magikh0e/synack-pinball/assets/social-preview.png

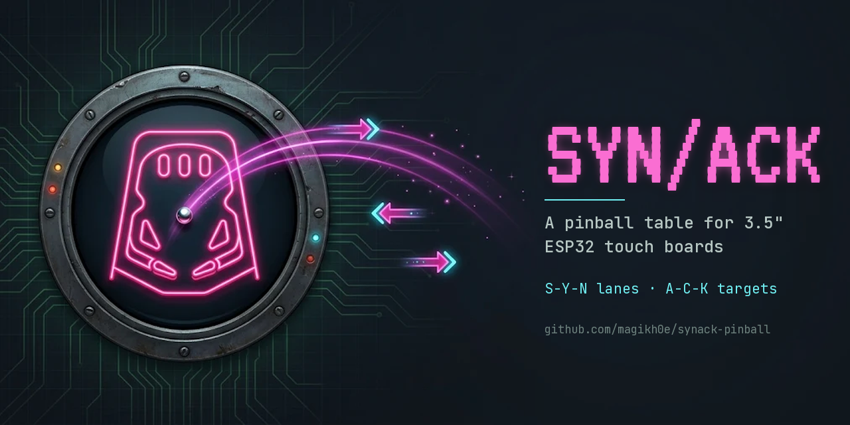
assets/social-preview.png
