magikh0e/synack-pinball/case/renders/back.png

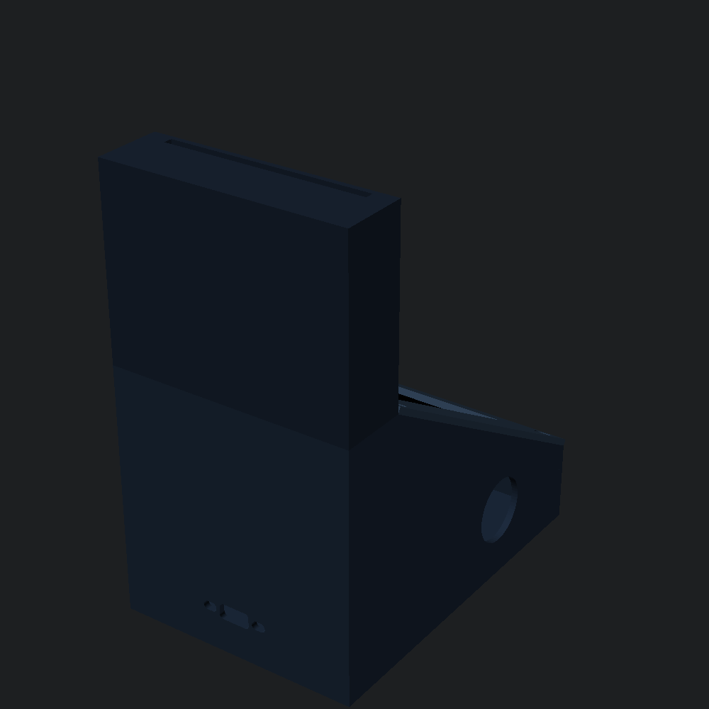
case/renders/back.png
