magikh0e/synack-pinball/case/stl/SYN_ACK.3mf

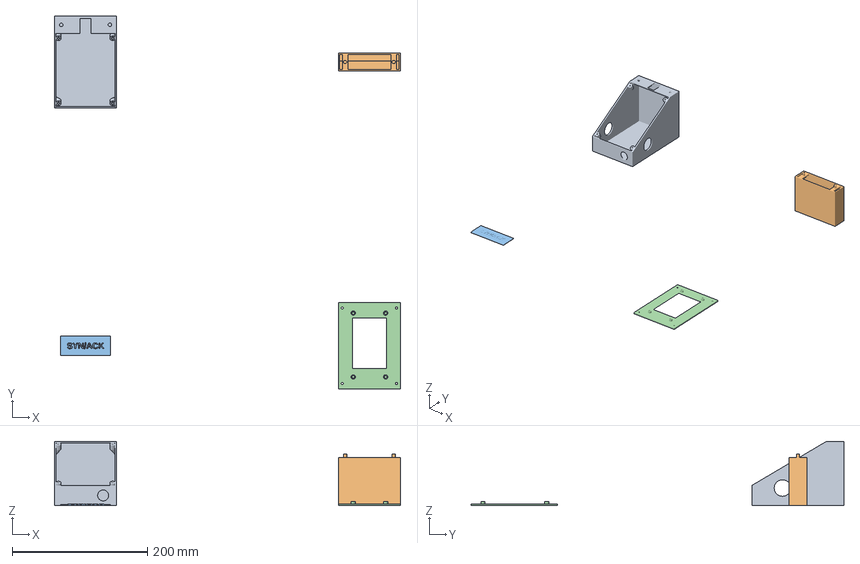
[picture p11: CAD file, 2026-10-19]
case/stl/SYN_ACK.3mf
512.0 x 551.9 x 95.0 mm
body.stl
backbox.stl
marquee.stl
deck.stl
