magikh0e/synack-pinball/case/stl/body.stl

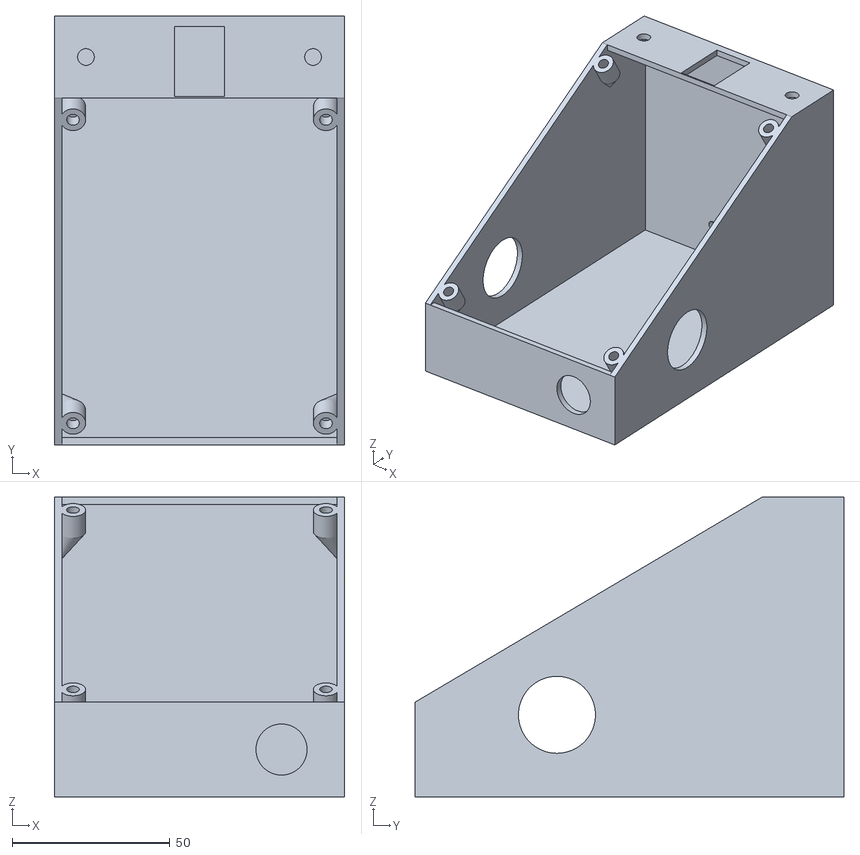
[picture p12: CAD file, 2026-10-19]
case/stl/body.stl
92.0 x 136.0 x 95.0
