magikh0e/synack-pinball/case/stl/backbox.stl

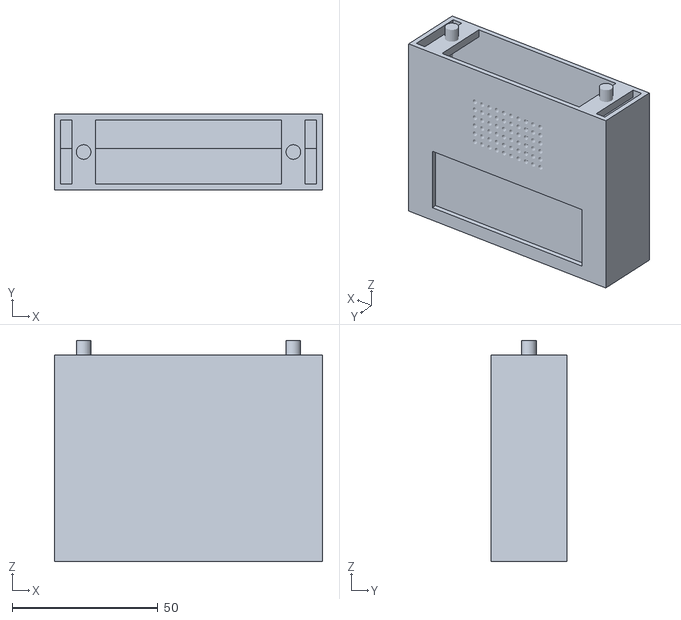
[picture p13: CAD file, 2026-10-16]
case/stl/backbox.stl
92.0 x 26.0 x 76.0
