magikh0e/synack-pinball/case/stl/deck.stl

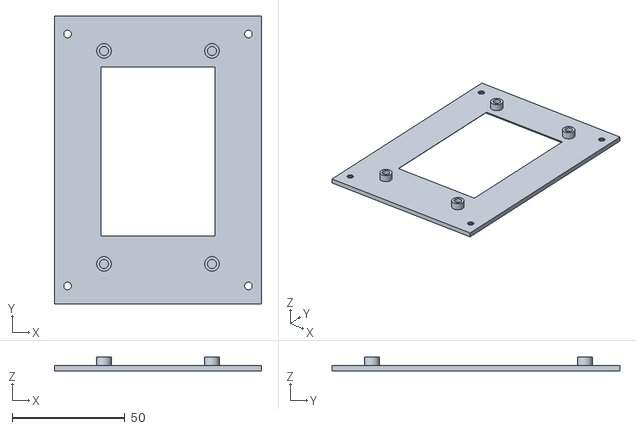
[picture p14: CAD file, 2026-10-15]
case/stl/deck.stl
92.0 x 127.8 x 6.10
