magikh0e/synack-pinball/case/stl/marquee.stl

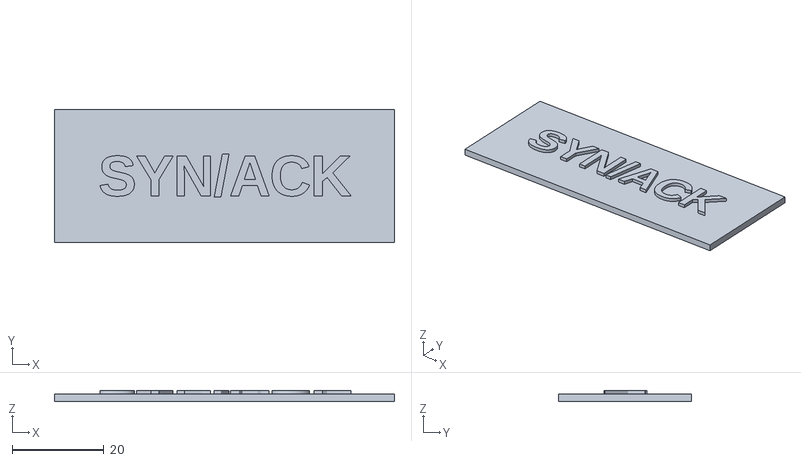
[picture p15: CAD file, 2026-10-11]
case/stl/marquee.stl
74.0 x 29.0 x 2.39
