magikh0e/synack-pinball/docs/MAKING-OF.md

# The making of SYN/ACK

the finished cabinet mid-game, with the blue left flipper button lit and the green SYN/ACK marquee

SYN/ACK is a pinball table for 3.5-inch ESP32 touch boards: a 320 × 480 neon
playfield where the lanes spell SYN, the targets spell ACK, and completing the
handshake floods the table with balls. I started it on a Sunton "CYD", moved
it to an ESP32-S3 board, and ended up putting it in a printed tabletop cabinet
with real arcade buttons and a backbox. This is how it got there, and the
problems worth remembering along the way.

## Two boards, one table

| | Sunton ESP32-3248S035R ("CYD") | LCDwiki ES3C35P |
|---|---|---|
| Chip | ESP32 | ESP32-S3, with PSRAM |
| Display | ST7796, SPI | ST77922, quad SPI |
| Touch | XPT2046, resistive, one point | capacitive, multi-touch |
| Sound | a buzzer on a PWM pin | ES8311 codec and amplifier |
| Lights | an RGB LED | an RGBW NeoPixel |

Both are 320 × 480 portrait, so the table itself never had to change. I put
everything that does differ behind one small interface:

```mermaid
flowchart LR
  subgraph portable["portable C++: runs on both boards and on a PC"]
    game["game.hpp<br/>physics, rules, scoring"]
    render["render.hpp<br/>draws the table"]
    bot["bot.hpp<br/>the demo player"]
  end
  main["main.cpp<br/>frame loop, dirty rectangles,<br/>sound, lamps, idle"]
  board["board.hpp"]
  cyd["board_cyd.cpp"]
  s3["board_es3c35p.cpp"]
  sim["host/sim.cpp<br/>tests on a PC"]
  main --> game & render & bot
  main --> board
  board --> cyd & s3
  sim --> game & render & bot
```

I kept `game.hpp` plain C++ with no Arduino in it, and that turned out to be
the most important decision in the project: the same physics and rules compile
into a test program on a PC, where a bot can play hundreds of balls in seconds.

## The table

multiball in the attract demo the title screen the game over screen

*Real screenshots, read back off the CYD's panel over serial.*

I built the theme around the TCP handshake:

- Lighting all three **SYN lanes** at the top raises the multiplier (up to 5×)
  and arms SYN.
- Knocking down all three **ACK targets** on the right scores 5,000, or a
  25,000 **HANDSHAKE** if SYN is armed, and relights the kickback.
- A HANDSHAKE starts **SYN FLOOD**: two more balls are plunged in and
  everything scores double. The second HANDSHAKE in a game also earns an extra
  ball.
- The **UPLINK ramp** climbs the right side, crosses over the top and drops the
  ball into the left inlane. It lights the next SYN lane, and during multiball
  it's a 15,000 jackpot.
- A **spinner** in the left orbit pays double while SYN is armed.
- A **skill shot** zone on the plunger's power meter, a kickback in the left
  outlane, a ball save, and an end-of-ball bonus count-up.

When nobody is playing, a bot plays a silent demo game with a light show, and
it never sets the high score.

### High scores and initials

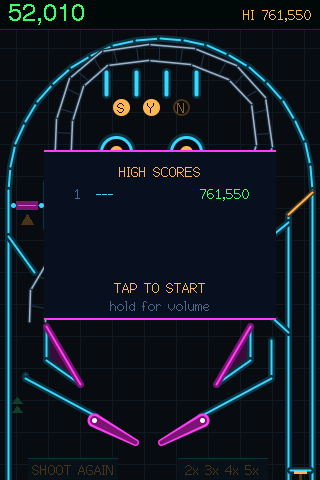
[picture p16: docs/guide/high-scores.png]
the title panel showing the HIGH SCORES table, with TAP TO START and hold for volume below it


Like an arcade machine, SYN/ACK keeps a top-five table. A score that makes the table brings up the classic
three-letter entry on the game-over screen, worked with the flipper buttons:

- a flipper steps the letter back or forward,
- both flippers together (or the launch button) take it and move to the next,
- and if you walk away, the initials are kept as they are after 30 seconds.

The one subtle part was the timing. If a flipper stepped the letter the moment
it went down, pressing both to confirm would first step the letter with
whichever thumb landed first. So a flipper only steps the letter when it's let
go, and only if the other flipper wasn't pressed in the meantime. On the CYD,
the middle of the screen counts as both flippers, so it works by touch alone.

Between games the title panel takes turns with the table, every six seconds.
The table lives on the board as one small block of settings memory. When I
added it, my existing high score carried over as the #1 entry, with "---"
for initials.

## Physics: small steps and capsules

The ball moves in fixed steps of 1/600 of a second, however fast the screen
draws. I made every wall, post, sling, target and flipper either a circle or a
**capsule** (a line segment with a radius), so a single closest-point routine
handles every collision. Flippers carry their surface speed into the bounce,
which is what makes a flick feel like a flick.

I tuned it by measurement more than by feel. When I first played it the
flippers felt a bit weak, so their up speed went from 24 to 29 rad/s, and the
outlanes were eating too many balls. Narrowing the outlane gap did nothing,
because it was already barely wider than the ball; shortening the separator
above it is what worked. In a 600-ball bot run, outlane drains fell from about
75% to 53%.

The ramp's exit taught me how much small changes matter: angled slightly left,
it fed balls straight into the left outlane, and the average ball life fell
from 32 to 22 seconds. Pointed straight down, it feeds the flipper.

### The ball that slowed down

The most stubborn bug I hit was a ball that sometimes crawled down to the
flippers. It turned out to have three separate causes:

1. **The ramp crawled.** A weak shot could take 3.5 seconds to come back down.
   Now the ramp keeps a minimum speed past its crest.
2. **Slow motion.** When too many parts of the screen changed at once, the
   game fell back to redrawing everything, about 170 ms on the S3. The physics
   caps each frame's time step at 50 ms, so those frames played in slow motion.
   Now the extra changes are merged into the nearest existing rectangle.
3. **Rolling friction.** Each collision took a little speed off along the
   surface. But a ball *rolling* along a guide touches it on every step, 600
   times a second, so rolling was capped at about 50 px/s:

```cpp
// a touch of friction on real impacts only. A ball rolling along a
// guide or flipper "hits" it every substep as gravity presses it in, and
// braking each of those (600/s) capped rolling at ~50 px/s
if (vn < -60) {
  V tg = perp(n);
  rel = rel - tg * (dot(rel, tg) * 0.015f);
}
```

The roll down the inlane went from 2.6 seconds to 1.0, and I added a test that
measures it.

### The kickback that didn't kick

The left outlane has a kickback: when it's lit, a ball falling down the
outlane gets fired back up into play. My soak runs counted hundreds of
kickbacks firing, so I thought it was fine. But they counted the kick, not
whether it saved anything.

It didn't. The kickback fired the ball straight up, and right above the
outlane sits the exit wall of the left orbit, angled to throw balls coming
down the orbit back into play. A ball fired straight up hit that wall from
underneath and dropped back down the same outlane.

I ran into this while building [Hack the Planet](https://magikh0e.pl/pinball), my browser pinball game that
runs on SYN/ACK's physics. I fixed it there first, and the fix carried
straight back: start the ball in the middle of the outlane, and partway up
hook it to the right, under the wall instead of into it. The hook is checked
in every physics step, so a slow frame can't carry the ball past it:

```cpp
if (b.kick) {  // checked every substep, so a slow frame can't skip it
  if (b.v.y > 0) b.kick = false;  // fell back without reaching the hook
  else if (b.p.y < KICK_HOOK_Y) {
    b.kick = false;
    b.v = {KICK_OUT_VX, fmaxf(b.v.y, -KICK_OUT_VY)};
  }
}
```

I added a test that drops a ball into the outlane from three positions and
checks it comes back into play. All three failed before the fix. Together with
three smaller fixes I made in the same round, the average ball life in a
600-ball bot run went from 32.6 to 37.2 seconds, and left-outlane drains fell
from 140 to 89.

## Drawing fast

Redrawing the whole 320 × 480 screen every frame is far too slow over SPI, so
I have the game track **dirty rectangles**: the ball's old and new position, a lamp
that changed, the score. Each frame merges the overlapping ones and redraws only
those, through two 320 × 48 DMA buffers so one is drawn while the other is
sent. That runs at around 89 frames a second on the CYD.

When the whole screen does need redrawing, I spread it over ten frames, 48
rows at a time, instead of stalling one frame for 170 ms. The worst frame
dropped to about 32 ms on the S3 and 35 ms on the CYD.

### The diagonal smear

My first images on the ES3C35P came out sheared diagonally. The cause was in
the ST77922's datasheet: the start column and the width of a drawing window must
both be **multiples of 4**. Anything else is quietly misdrawn: each row lands a
few pixels off from the one before, so every update smears into a diagonal
staircase, worst wherever the ball has been.

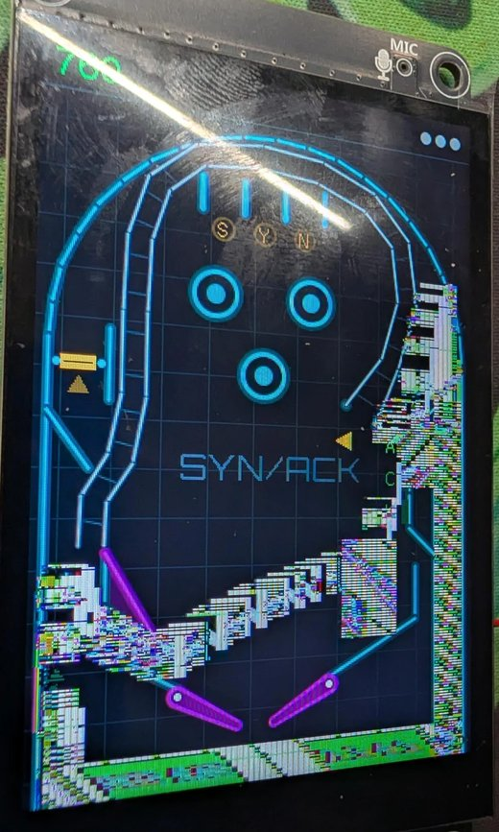
[picture p17: docs/guide/smear.jpg]
the ES3C35P's screen with diagonal staircases of garbled pixels wherever the ball has moved


The fix was to widen every rectangle to the next 4-pixel boundary before
drawing:

```cpp
const int A = board::ALIGN_X;  // 4 on the ES3C35P, 1 on the CYD
for (int i = 0; i < n; i++) {
  int x0 = d[i].x / A * A;
  int x1 = min((d[i].x + d[i].w + A - 1) / A * A, (int)pb::SCR_W);
  d[i].x = x0;
  d[i].w = x1 - x0;
}
```

The board's own screenshot command couldn't show this bug, since it reads a
copy of the image in memory rather than the panel. I only saw it in a photo of
the real screen.

## Sound

The CYD has a buzzer, so it plays one square-wave note at a time. The ES3C35P
has a real audio codec, so I gave it a small synthesizer: three voices mixed
together, each a square, pulse, triangle, saw or noise wave that can sweep in
pitch and decay like a struck sound. Bumpers thump, the spinner ticks, the
flippers make a short noise burst when they hit the ball, and multiball gets an
arpeggio fanfare. On the CYD the same events play the first note of each sound.

## Testing without the hardware

I test most of it without the hardware. `host/sim.cpp` builds the game for a
PC (inside a Docker container with g++). It:

- draws the table to image files,
- sweeps plunger strengths and flipper shots,
- lets the demo bot play 300 balls, failing if a ball escapes the table or a
  feature (multiball, the ramp, the lanes) never triggers,
- checks the rules one by one: multiball, the bonus count, the skill shot, the
  extra ball, and that the demo never sets the high score,
- and checks that redrawing only the dirty rectangles gives exactly the same
  pixels as a full redraw.

The long bot run found two places where the ball could get trapped (where the
inlane guide meets the flipper pivot, and under the slingshots) before I ever
saw one in play. On GitHub, every push builds the firmware for all three
targets and runs the tests.

One detour worth mentioning: the ESP32's compiler crashed outright with an
internal error once the bonus code was inlined into the main game loop. I
marked those helpers "don't inline", and that fixed it.

## Real buttons

On the CYD, I put the flipper buttons on the IO22 and IO21 pins of its
extension socket, and on the ES3C35P on its serial socket (IO43 and IO44, which are free
because the S3 talks to the PC over its own USB). On both, a launch button is
wired across the board's BOOT button: hold to charge the plunger, release to
fire.

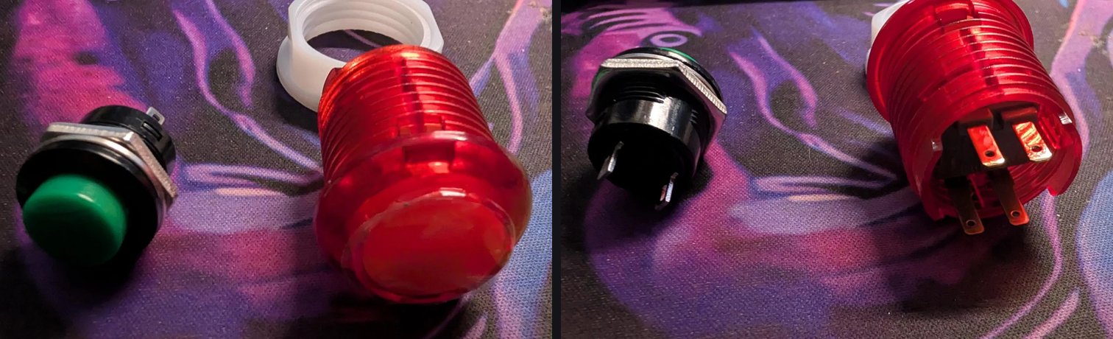
[picture p18: docs/guide/buttons.jpg]
a 16 mm metal push button with two tabs beside a red 24 mm arcade button with four tabs, front and back


*Left, the launch button: a 16 mm push button with two tabs. Right, a flipper
button: a 24 mm arcade button with an LED inside, so four tabs. The two switch
tabs come off the microswitch body, and the two lamp tabs off the LED holder
behind it. Both buttons' tabs are 2.8 mm wide, so they take 2.8 mm (0.110")
female spade connectors. Any colours work.*

Four things to watch:

- **"1.25 mm" isn't one connector.** JST GH, MX1.25 and a few other families
  all use 1.25 mm pin spacing, and they don't mate with each other. The
  ES3C35P's sockets take **MX1.25**. I bought the wrong kind twice before a
  kit of pre-crimped MX1.25 leads finally fit.

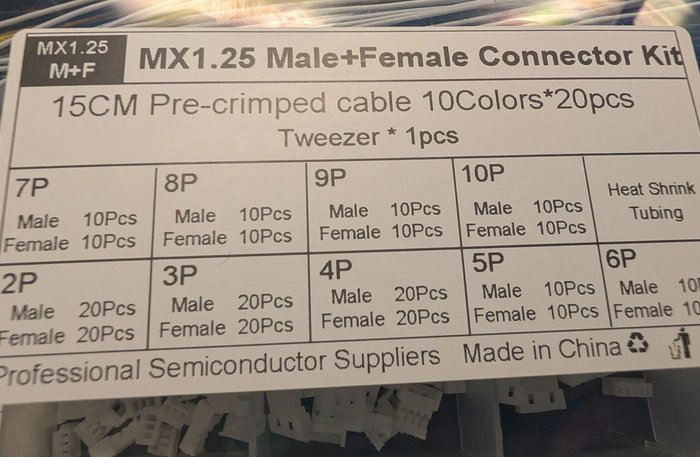
[picture p19: docs/guide/mx125-kit.jpg]
the label of an MX1.25 male and female connector kit with 15 cm pre-crimped leads
  

- The ES3C35P's serial socket has **5 V on pin 1** (marked with a small triangle
  and printed `5V`). Ground is pin 2. Read the labels printed on the board, not
  a guess from the schematic.
- My flipper buttons have 5 V LEDs, and the game lights them on IO45 and IO46.
  Those two pins decide how the chip starts up, so I switch each lamp through a
  transistor, which keeps the pin low while the board boots.
- **Don't solder onto an LED button's lamp tabs.** I burned out one button's
  lamp doing exactly that; the soldering heat cooked the LED. The tabs take
  2.8 mm spade connectors, so there's no need to solder at the button at all,
  and a dead lamp becomes a plug-in swap.

**How I ran the shared wires.** To keep the wire count down, I chained the
connections the buttons share. The buttons' negative (ground) tabs are
jumpered to each other, and one lead runs from the board's GND to one of them.
The lamps' 5 V tabs are chained the same way, with one lead from the board's
5 V pin to the first lamp. Only each lamp's − stays on its own wire, to its own
transistor; chain those and the game can't light one button without the other.

## The cabinet

### Concepts

I drew up three ideas around the board's real dimensions:

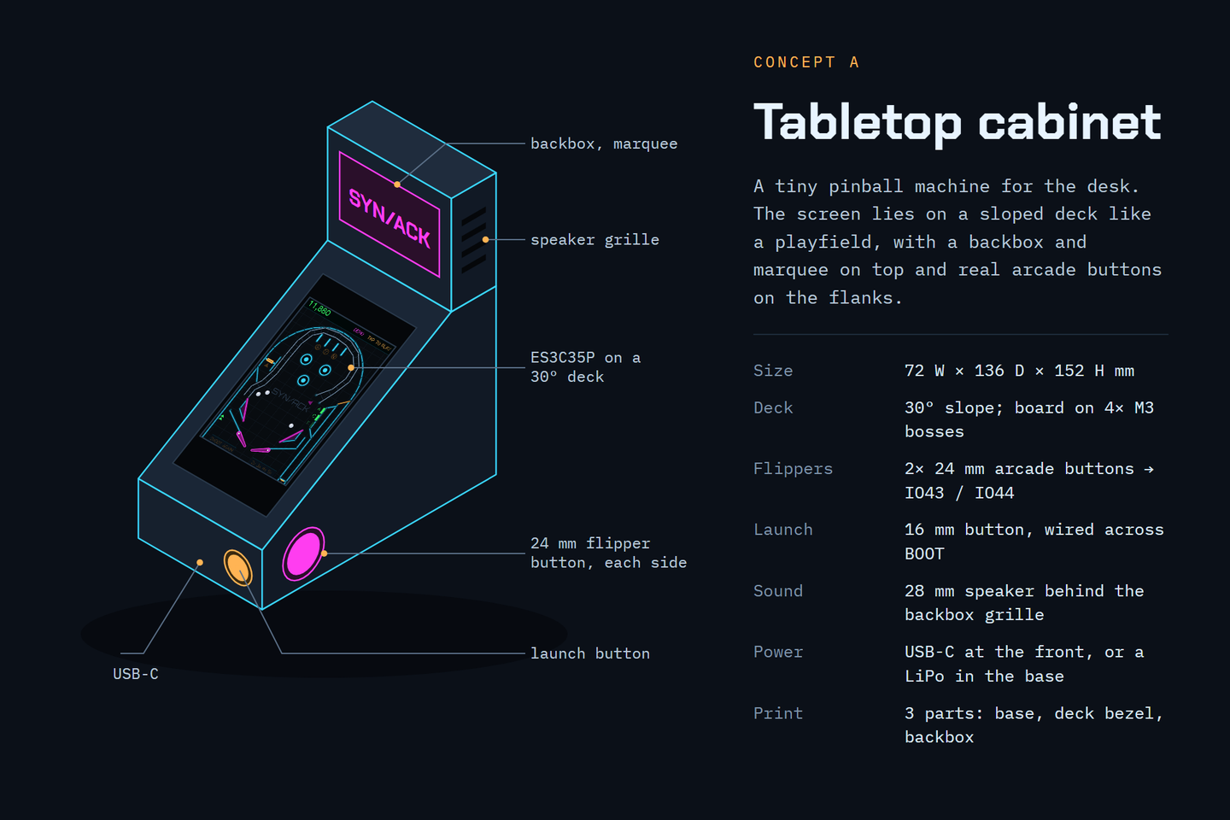
[picture p20: docs/guide/concept-a-cabinet.png]
Concept A: a tabletop cabinet


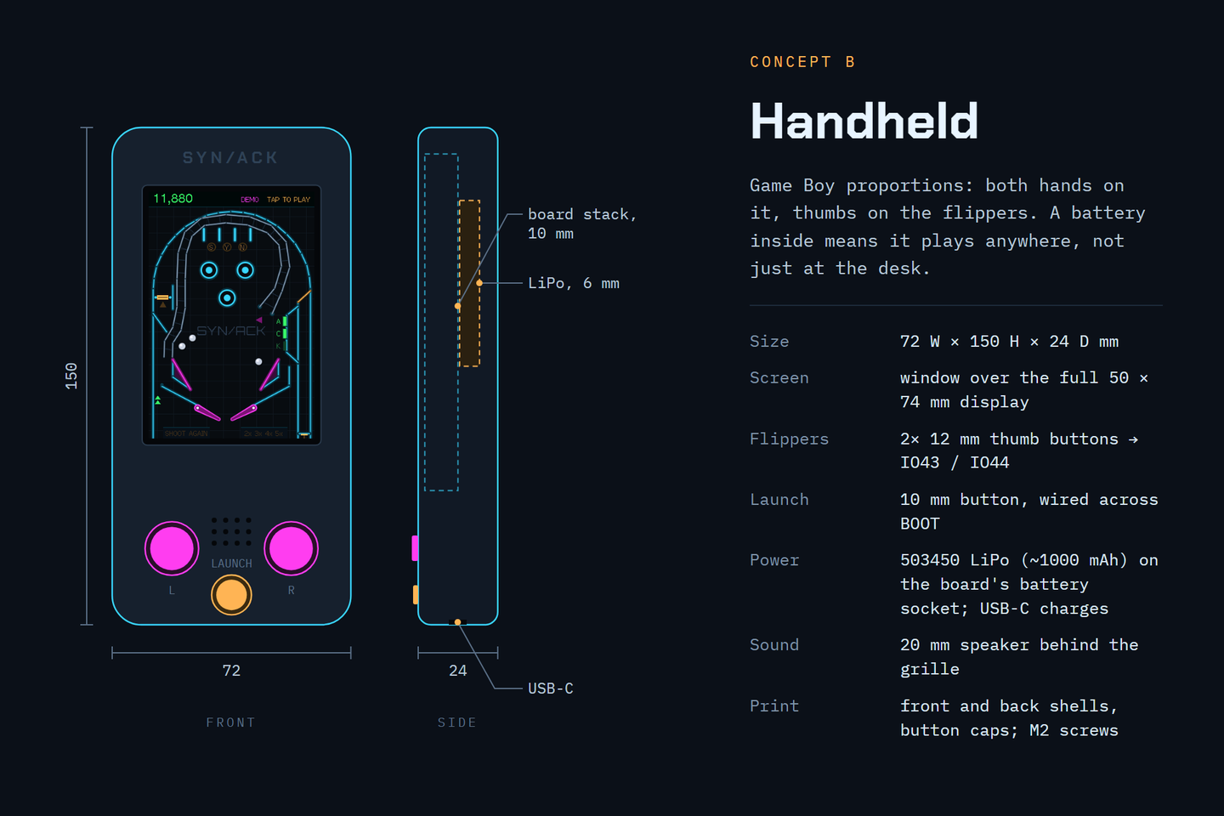
[picture p21: docs/guide/concept-b-handheld.png]
Concept B: a handheld


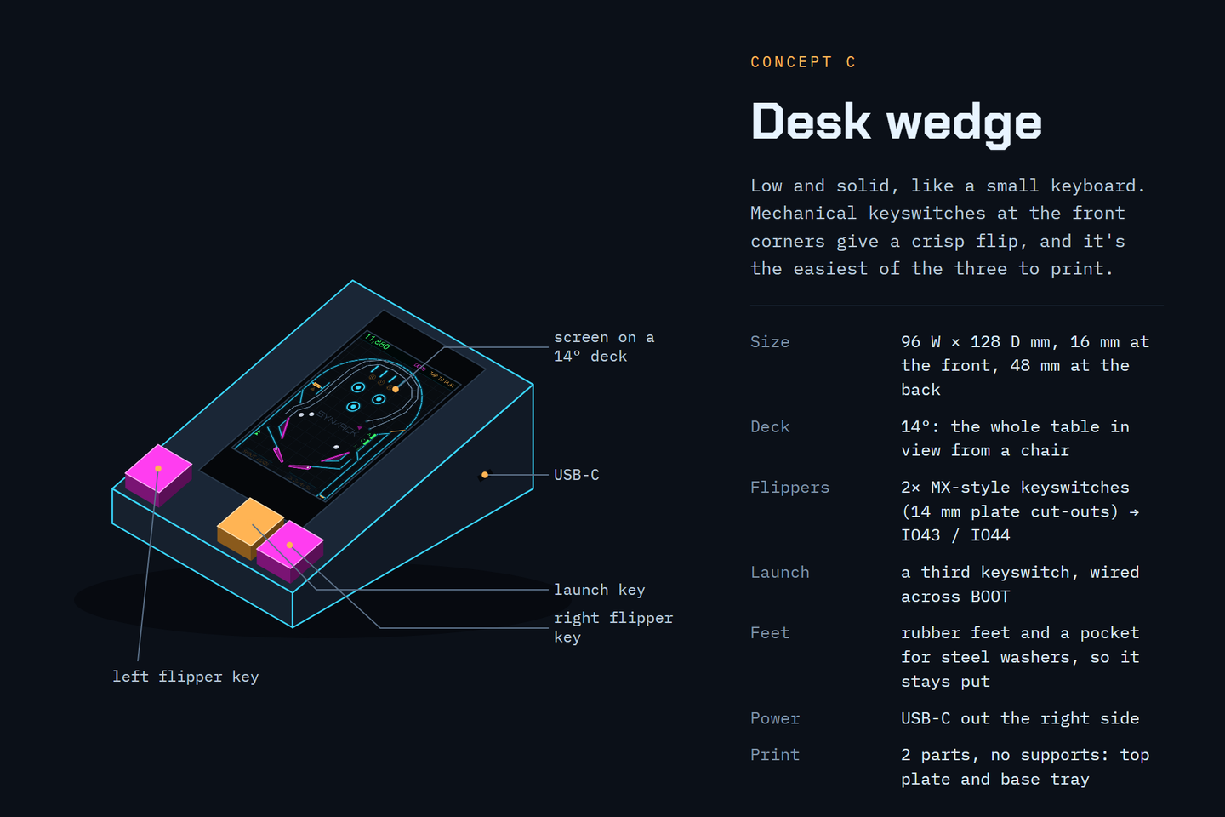
[picture p22: docs/guide/concept-c-wedge.png]
Concept C: a desk wedge


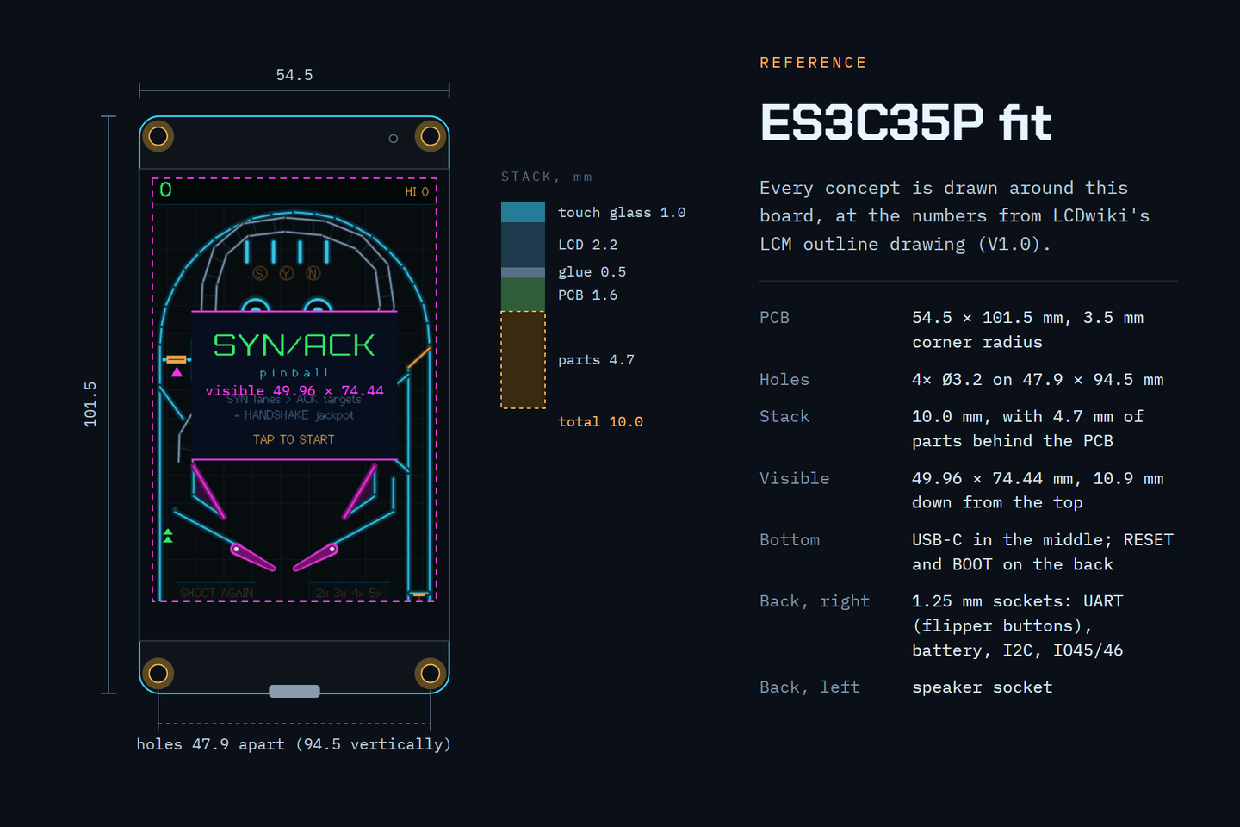
[picture p23: docs/guide/board-fit.png]
The ES3C35P fit reference all three were drawn around


I went with the tabletop cabinet: it looks like a pinball machine, it has room
for a proper speaker, and the arcade buttons sit where real flipper buttons
do.

### From concept to model

The case is one OpenSCAD file (`case/cabinet.scad`), driven by measurements:
the board's outline drawing, the buttons' datasheet, and the speaker as I
measured it. Changing a number reshapes every part that depends on it.

The concept was 72 mm wide. When my 24 mm arcade buttons arrived, they stuck
out about 41 mm behind the side wall once their connectors were on, and the two
face each other, so the cabinet grew to 92 mm. The model checks this itself: rendering it
prints the gap between the two buttons' connectors, and fails if any
clearance goes negative.

A "clash" render checks the hardware against the printed parts: the USB plug
and socket, the speaker and the marquee card, both in place and along the path
each takes to get there. It has to come out empty.

the assembled model cutaway with the board, buttons and hardware

### Turning the board upside down

The ES3C35P has its USB-C, RESET and BOOT at one end. Mounted the obvious way,
the USB would face the player. So I mounted it upside down: the USB faces the
back of the cabinet, and its sockets land nearer the buttons and the speaker. The
`es3c35p-cabinet` build turns the picture and the touch 180° to match. Since a
rectangle turned half a turn is just its pixels in reverse order at the mirrored
position, that's a few lines in the board layer and nothing anywhere else.

### Getting the USB out the back

A panel-mount USB-C socket sits in the back wall, with a short extension to the
board. With a straight plug, I had to bend the cable back hard inside the
backbox to fit it. A small 90° adapter on the board's port turns the plug down
toward the back wall instead, and the cable then reaches the socket in one
loose loop:

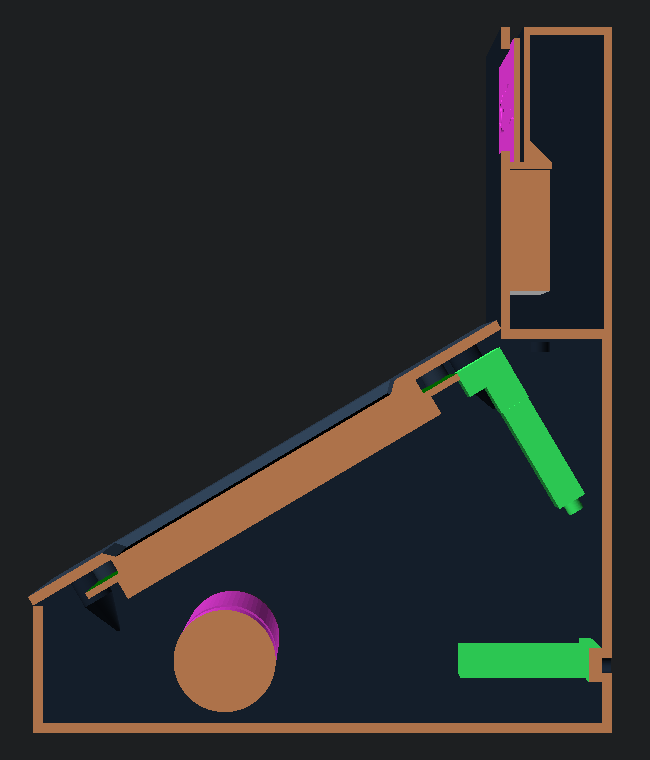
[picture p24: docs/guide/usb-route.png]
side cutaway: the plug turned down by the 90-degree adapter, the socket low on the back wall


### Printing it

- **Four parts:** body, deck, backbox and marquee card, none needing supports.
- **The backbox prints upside down.** An open-bottomed box has a roof in every
  other orientation; this way every wall rises straight from the bed. The only
  bridge left is the top of the marquee window.
- **The speaker** (40 × 28 × 9 mm) slides up into the backbox from below,
  against the grille, until it stops under a shelf.
- **The marquee card** drops in through a slot in the top and stands on that
  shelf. Its letters are raised 0.8 mm, so the slot needs room for them; my
  first slot was too tight to print. Black letters on a black card vanished,
  so I printed the card in green with black letters, and now it reads from
  across the room.

### The inside

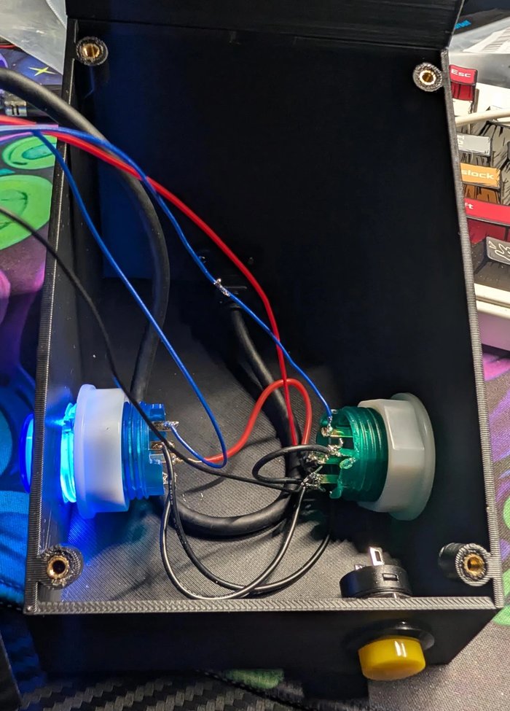
[picture p25: docs/guide/inside.jpg]
inside the cabinet body before the deck goes on: two arcade buttons on the side walls, one lit blue, wires soldered to their tabs, the USB-C extension coiled on the floor and the yellow launch button in the front wall


The inside. I ran out of spade connectors and flux partway through, so the
buttons are soldered and it's a bit of a mess, but it works.

both boards running the same game

## What it taught me

- **Keep the game portable.** Being able to run the real physics on a PC paid
  for itself many times: tuning, soak tests, and catching traps before I ever
  hit them.
- **Measure, then change one thing.** The outlanes, the ramp exit and the slow
  ball were all settled by numbers from bot runs, not by feel.
- **Count outcomes, not triggers.** The kickback "fired" hundreds of times in
  testing while saving almost nothing. A test of what happens next caught it.
- **Per-contact effects must ignore resting contact.** Anything applied "on
  every collision" also runs 600 times a second on a ball that's just rolling.
- **Read the datasheet's fine print.** The 4-pixel rule and the 5 V pin were
  both written down. They just weren't where I looked first.
- **Keep the iron off the LEDs.** Spade connectors on the button tabs would
  have saved me a lamp.
- **Name the connector family, not just the pitch.** "1.25 mm" fits three
  different plugs, and only one of them fits the board.
- **Check how parts go in, not only where they end up.** A model can fit
  perfectly once assembled and still be impossible to assemble.
- **Photos beat screenshots** for anything the panel itself gets wrong.
