magikh0e/synack-pinball/(commit log)

2026-10-11 SYN/ACK pinball for the CYD 3.5" and the ES3C35P (ESP32-S3)
    A 320x480 portrait pinball table: flippers, plunger, pop bumpers,
    slingshots, S/Y/N rollover lanes, A/C/K targets, a spinner, the UPLINK
    wire ramp, left-outlane kickback, SYN FLOOD three-ball multiball,
    ball save, an attract-mode demo, and a high score kept in NVS.
    - game.hpp: geometry, physics (1/600 s substeps, capsule colliders,
    ball-ball collisions) and rules, in pure C++
    - render.hpp: draws the world into any screen rectangle; only dirty
    rects are redrawn, with overflow merged rather than forcing a full
    redraw
    - board.hpp: hardware layer, with board_cyd.cpp (ST7796 + XPT2046) and
    board_es3c35p.cpp (ST77922 q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
    [LGFX_CYD35.hpp, St77922Qspi.cpp, St77922Qspi.h, board.hpp, board_cyd.cpp, board_es3c35p.cpp, bot.hpp, es8311.cpp]
2026-10-11 Make the ST77922 driver comments project-neutral
    The driver came from an earlier bring-up; its notes referred to that
    project rather than to this table.
2026-10-11 Cite the vendors' documents for both boards' hardware
    ES3C35P: every pin is checked against LCDwiki's IO allocation table and
    schematic. The table's description column swaps the touch reset and
    interrupt; the schematic (CTP_RST on module pin 36 = IO48, CTP_INT on
    pin 37 = IO47) and the vendor touch library agree with the code. The
    same table shows IO43/44 usable as plain IO when UART0 is idle, which
    corrects the note that the board had no pins for flipper buttons.
    CYD: Sunton's spec sheet gives the panel and connectors but no GPIO
    map, so the pins are cited as verified on the board.
    Also re-encodes README.md as UTF-8 (it was cp1252, which garbled the
    middle dot in "DEMO · TAP TO PLAY").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
    [LGFX_CYD35.hpp, St77922Qspi.cpp, St77922Qspi.h, board_cyd.cpp, board_es3c35p.cpp]
2026-10-11 Add physical flipper buttons on the ES3C35P
    The flippers go on the serial-port header: IO43 (TXD0, pin 3) for the left
    flipper and IO44 (RXD0, pin 4) for the right, with GND on pin 1. Each is a
    momentary switch from the pin to GND, using the internal pull-ups. The
    console is native USB, so UART0 is idle and the vendor's IO table allows
    both as plain IO. The board puts 100R series resistors on both lines.
    IO45/46 on the expansion header were avoided: they are strapping pins,
    and a pull-up on IO45 can change the flash voltage at reset.
    The README now has a button table for each board.
    [board_es3c35p.cpp]
2026-10-11 Add bonus, blinking lamps, synth sound, idle sleep; fix slow rolling
    - End-of-ball bonus: ramps 1,000, lanes 250, targets 250 and spinner
    half-turns 25, times the multiplier, counted into the score after
    each drain. Any press hurries it.
    - Blinking lamps mark the shot that matters: the A/C/K targets and the
    spinner arrow once SYN is armed, the ramp arrow while the jackpot is
    lit, and SHOOT AGAIN for the last 2 s of a ball save.
    - Sound: board::tone() takes a waveform, a pitch sweep and a length.
    The ES3C35P synthesizes square, pulse, triangle, saw and noise with a
    struck-sound decay; the CYD's buzzer plays the start pitch. New sound
    design throughout, including a flipper "thwac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
    [board.hpp, board_cyd.cpp, board_es3c35p.cpp, game.hpp, main.cpp, render.hpp, sim.cpp]
2026-10-11 Add skill shot, extra ball, 3-voice sound, light show; CI
    - Skill shot: a zone beside the plunger's power meter that moves each
    ball. Releasing inside it scores 5,000. (Plunges can't aim at the
    S/Y/N lanes on this table; strong ones all orbit to the spinner, so
    the skill is in the timing.)
    - Extra ball: the second HANDSHAKE of a game. SHOOT AGAIN stays lit
    until it's played, and the same ball number goes again.
    - Sound: three voices. The ES3C35P mixes them, so a flipper hit no
    longer cuts off a bumper; ticks and clicks share one voice. The CYD's
    buzzer plays the newest.
    - Between games the lamps chase around the table; on a new high score
    they all flash.
    - Full redraws (game st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
    [board.hpp, board_cyd.cpp, board_es3c35p.cpp, game.hpp, main.cpp, render.hpp, sim.cpp]
2026-10-11 Add a printable tabletop cabinet and an upside-down board build
    case/ holds a parametric OpenSCAD model of a small pinball cabinet for the
    ES3C35P, with ready STLs, renders and a README covering hardware, assembly
    and wiring:
    - body: 92 x 136 x 152 mm, with 24 mm arcade-button holes in the sides,
    a 16 mm launch hole in the front (LAUNCH_BTN=24 for a third arcade
    button), a USB-C panel-socket mount in the back, and deck bosses for
    M3 heat-set inserts
    - deck: a 30-degree plate with a screen window and board standoffs
    - backbox: a 2030 cavity-speaker pocket and grille, and a marquee window
    with slide-in rails
    - marquee: the SYN/ACK card
    The model checks button clearances with assertions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
    [backbox.stl, body.stl, cabinet.scad, deck.stl, marquee.stl]
2026-10-11 Fit the 40.4 x 28.4 mm speaker; add a photo of both boards
    The backbox now derives its height from the speaker pocket and the marquee
    card (75 mm, cabinet 170 mm tall), the grille covers the larger speaker, and
    the clash test checks the speaker as well as the USB-C plug and socket.
    [backbox.stl, body.stl, cabinet.scad, deck.stl]
2026-10-15 Backbox: speaker slides up from below; card drops in from the top
    The speaker pocket was closed on every side, so the speaker couldn't go in.
    It's gone: the speaker now slides up from the backbox's open bottom against
    the grille and stops under a shelf, which also carries the marquee card. The
    card drops in through a slot in the top (the old rails could only be reached
    past the pocket). The backbox now prints upside down, so no wall is a roof,
    and the clash test also checks the speaker's and the card's way in.
    [backbox.stl, body.stl, cabinet.scad, deck.stl]
2026-10-16 Backbox: more play in the marquee card's slot for the raised text
    [backbox.stl, cabinet.scad]
2026-10-17 Lit flipper buttons, correct socket pinouts, 90-degree USB-C adapter
    - ES3C35P: drive 5 V LED arcade buttons from IO45/IO46 (through NPN
    transistors): a glow in play, a flare while pressed, flashes on the big
    events, and an alternating breathe off the table. The CYD ignores them.
    - The serial socket's pin 1 is 5V and pin 2 GND (read from the vendor's
    silkscreen); the docs had them swapped. Buttons go on GND, never pin 1.
    - Cabinet model: a 90-degree adapter on the board's port turns the USB-C
    extension down toward the back wall instead of up into the backbox; the
    clash test covers it. README: the assembled cabinet photo.
    [cabinet.scad]
2026-10-17 Docs: the board's sockets are MX1.25; the connector kit that fit
2026-10-17 Making-of: photo of the launch and flipper buttons
2026-10-17 Making-of: simpler button photo caption
2026-10-17 Making-of: tidy the button photo caption
2026-10-17 Docs: 2.8 mm button tabs and the spade connectors they take
2026-10-17 Docs: the 2.8 mm tab size is the arcade button's
2026-10-17 Docs: the launch button's tabs are 2.8 mm too
2026-10-18 CYD button socket takes MX1.25 plugs, not JST GH
2026-10-18 Fix kickback, held presses, repeat ball saves and the stuck-ball watchdog
    - Kickback: centre the ball in the outlane and hook it right below the left
    orbit's exit; fired straight up, it hit the exit from underneath and fell
    back into the outlane.
    - Only a fresh press hurries the end-of-ball bonus, and a touch held over from
    before a serve can't charge the new ball.
    - One ball save per ball: a saved ball comes back with no second save or
    skill shot.
    - Watchdog: a ball that stays within 8 px for 3 s gets nudged even while a
    flipper is held; only a ball cradled on a held flipper is exempt.
    - Host tests for each; in the 600-ball soak, average ball life goes from
    32.6 s to 37.2 s and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
    [game.hpp, sim.cpp]
2026-10-18 Ball-ball hits: a ball pinned against a wall or flipper acts heavier
    A ball touching a wall or flipper in the last two substeps, pushed into it by
    another ball, now has 1/10 the inverse mass. As equals, a ball dropped onto
    one cradled on a flipper stopped almost dead (18% of its speed back); now it
    bounces off (68%). Host test added; the soak is unchanged apart from slightly
    longer ball life.
    [game.hpp, sim.cpp]
2026-10-18 High-score initials and a top-5 table, volume by holding the screen, ball clack
    - A top-five score asks for three initials on the game-over screen: a flipper
    steps the letter when let go, both flippers (or launch) take it, and 30 s
    idle keeps them. The attract panel alternates the title with the table.
    The table is one NVS blob; an old single high score becomes #1 as "---".
    - Off the table, a short touch is a tap (on release) and a touch held 0.8 s
    steps the volume, like BOOT, for cabinets where BOOT is out of reach.
    - Balls hitting each other in multiball make a clack, brighter for hard hits,
    at most one per 0.06 s.
    - Serial 'h' prints the table and 'h0' clears it. Host tests for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
    [game.hpp, main.cpp, render.hpp, sim.cpp]
2026-10-18 Docs: don't solder onto LED button lamp tabs
2026-10-18 Making-of: how I ran the shared wires
2026-10-19 Cabinet: raise the flipper buttons so their nuts can turn
    The inside nut (about 34 mm across its corners) is wider than the bezel, and
    at 17 mm it hit the floor, so it went on crooked and couldn't be tightened.
    The buttons now sit at 26 mm: 6.6 mm of room for the nut, about 6 mm below
    the board. The model checks the nut's room, and the clash test now includes
    both buttons and their nuts against the printed parts and the board's back.
    [body.stl, cabinet.scad]
2026-10-19 Cabinet: Creality Print project for the four parts
    [SYN_ACK.3mf]
2026-11-10 assets: badge and social card
    A hot-pink neon pinball table with three lane lights, pop bumpers and a
    chrome ball in flight, ringed by handshake arrows, in the riveted frame
    the other repo badges use, under SYN/ACK and PINBALL banners. 512x512
    RGBA with the edge feather ending at the frame, shown at the top of the
    README.
    The social card is new art with the title in VT323 and JetBrains Mono,
    1280x640.
